w29ahmed/ECE298-Bicycle-Sensor/Prototype Design/F2019_ECE-298_Components/3d_Models/E298_led-3r_red.step

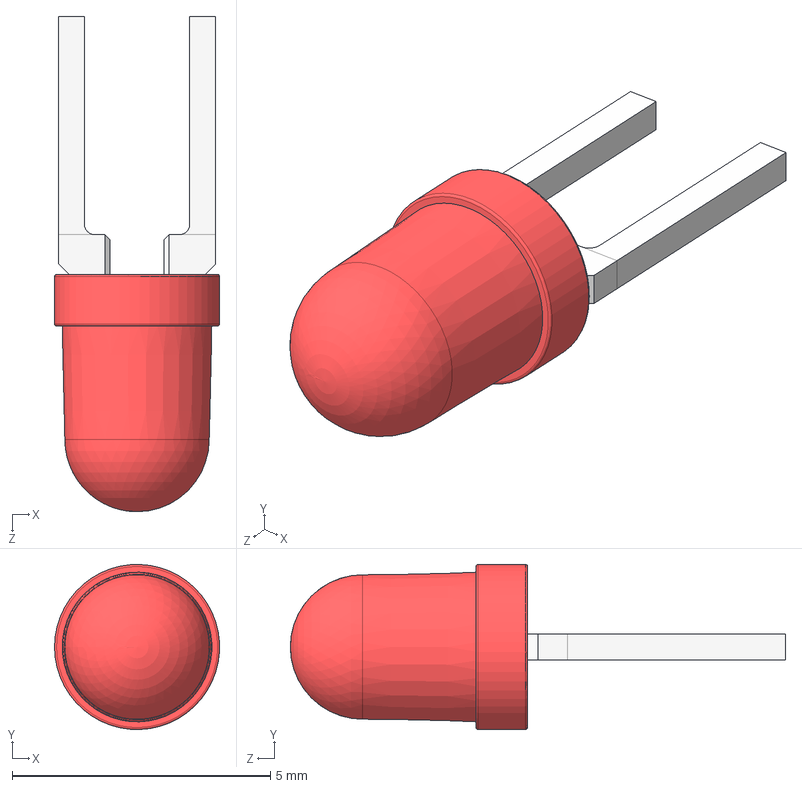
[picture p15: CAD file, 2019-10-06]
Prototype Design/F2019_ECE-298_Components/3d_Models/E298_led-3r_red.step
3.20 x 3.20 x 9.60 mm
