w29ahmed/ECE298-Bicycle-Sensor/Prototype Design/F2019_ECE-298_Components/3d_Models/E298_sot353.step

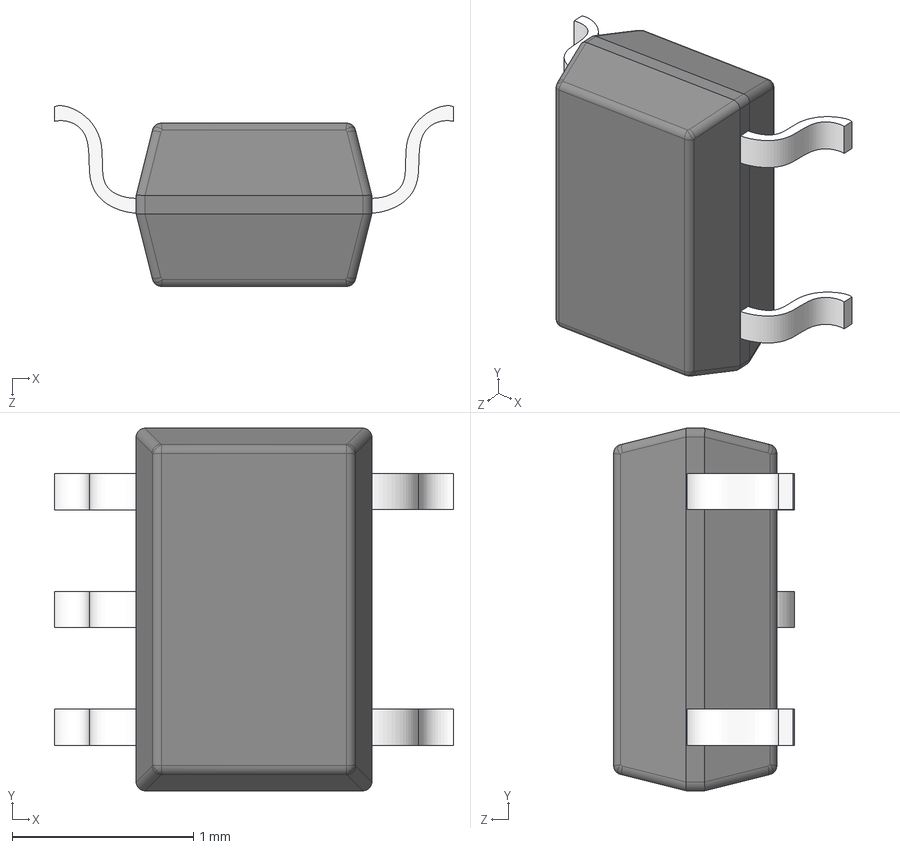
[picture p16: CAD file, 2019-10-06]
Prototype Design/F2019_ECE-298_Components/3d_Models/E298_sot353.step
2.20 x 2.00 x 0.996 mm
sot353
sot353_001
