w29ahmed/ECE298-Bicycle-Sensor/Prototype Design/F2019_ECE-298_Components/3d_Models/E298_hdr-1x5t_2.54_sh15x8.step

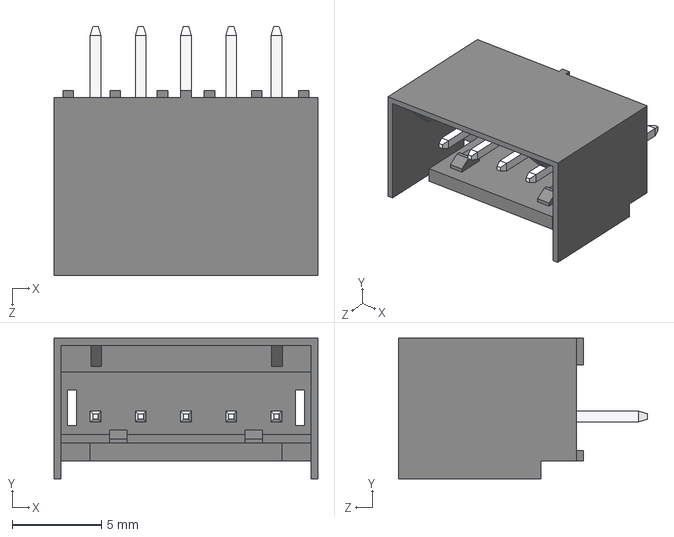
[picture p17: CAD file, 2019-10-06]
Prototype Design/F2019_ECE-298_Components/3d_Models/E298_hdr-1x5t_2.54_sh15x8.step
14.8 x 7.90 x 14.0 mm
