w29ahmed/ECE298-Bicycle-Sensor/Prototype Design/F2019_ECE-298_Components/3d_Models/E298_led-5r_green.step

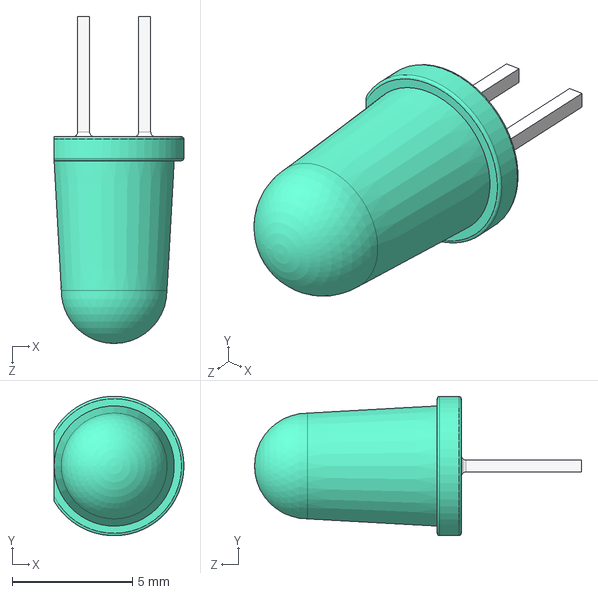
[picture p19: CAD file, 2019-10-06]
Prototype Design/F2019_ECE-298_Components/3d_Models/E298_led-5r_green.step
5.40 x 5.80 x 13.6 mm
