w29ahmed/ECE298-Bicycle-Sensor/Prototype Design/F2019_ECE-298_Components/3d_Models/E298_sot23-5.step

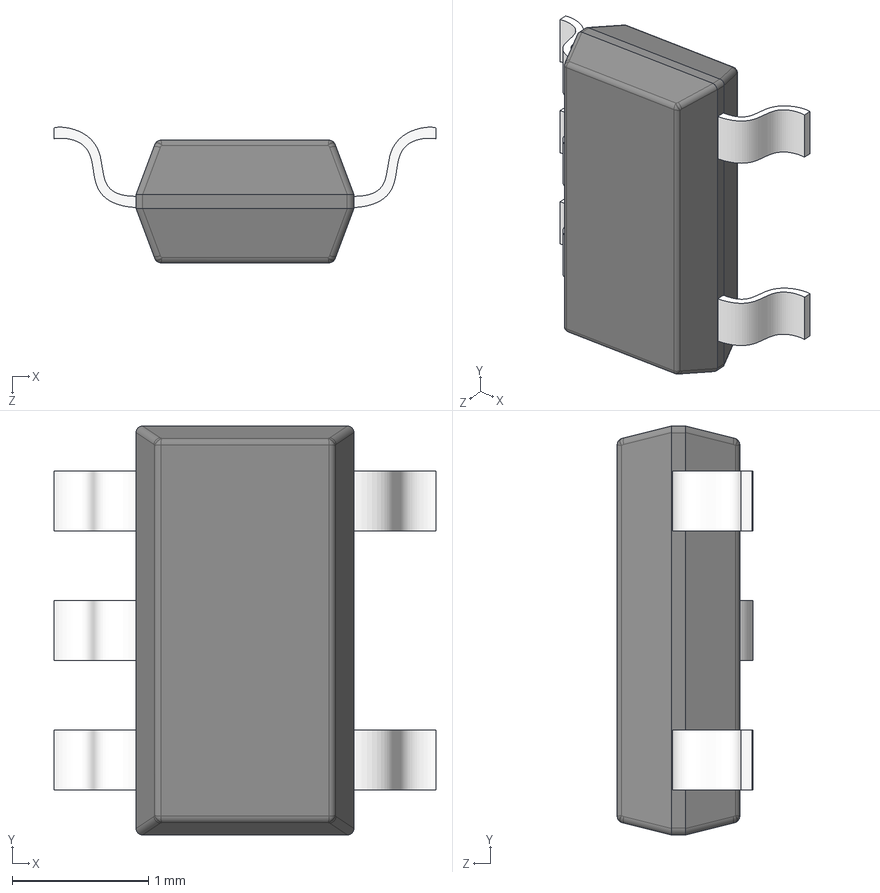
[picture p20: CAD file, 2019-10-06]
Prototype Design/F2019_ECE-298_Components/3d_Models/E298_sot23-5.step
2.80 x 3.00 x 0.995 mm
sot23-5
sot23-5_001
