w29ahmed/ECE298-Bicycle-Sensor/Prototype Design/F2019_ECE-298_Components/3d_Models/E298_TC-33X-2.step

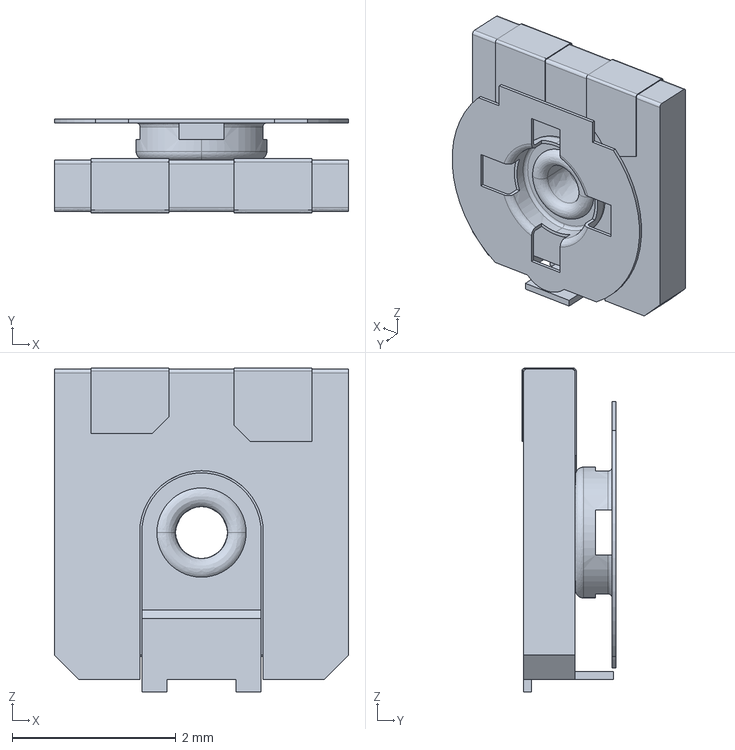
[picture p21: CAD file, 2019-10-06]
Prototype Design/F2019_ECE-298_Components/3d_Models/E298_TC-33X-2.step
3.60 x 1.15 x 3.96 mm
