w29ahmed/ECE298-Bicycle-Sensor/Prototype Design/F2019_ECE-298_Components/3d_Models/E298_EM-9745P-1.step

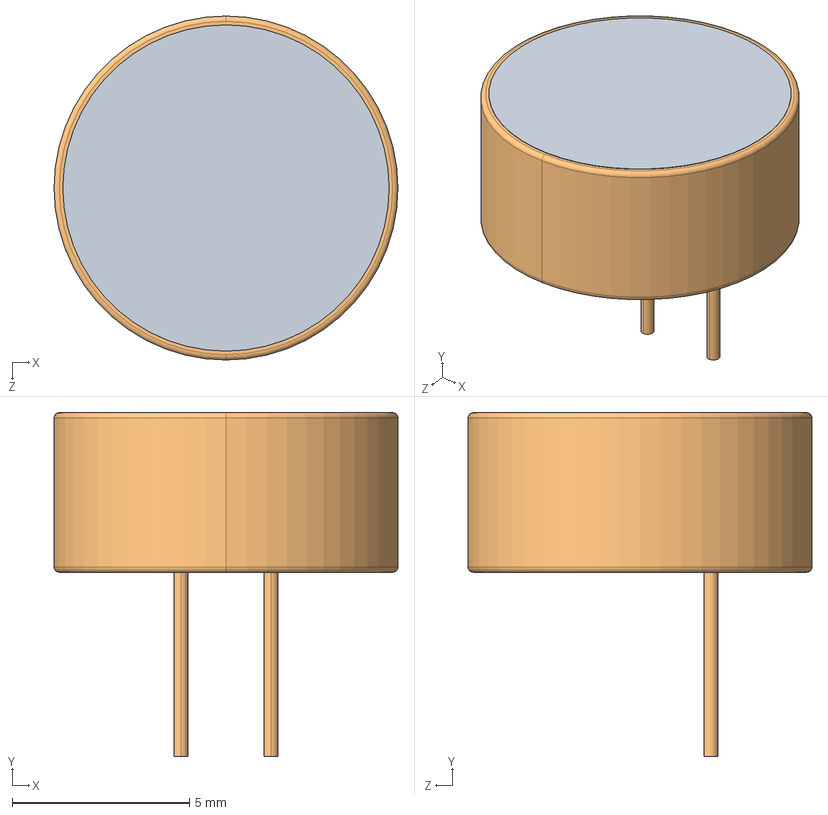
[picture p23: CAD file, 2019-10-06]
Prototype Design/F2019_ECE-298_Components/3d_Models/E298_EM-9745P-1.step
9.70 x 9.71 x 9.70 mm
