w29ahmed/ECE298-Bicycle-Sensor/Prototype Design/F2019_ECE-298_Components/3d_Models/E298_to-92.step

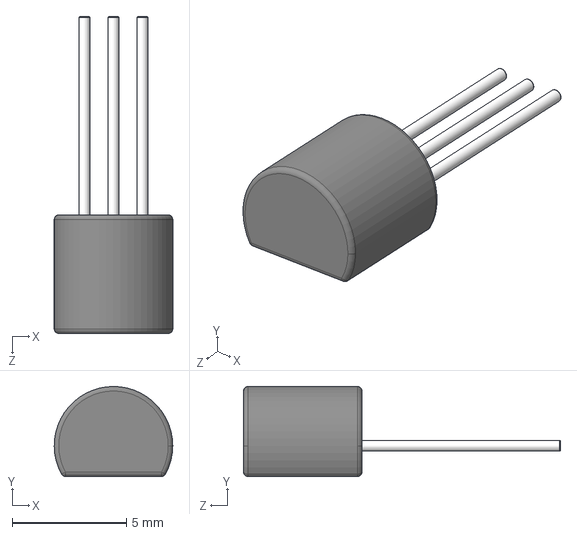
[picture p24: CAD file, 2019-10-06]
Prototype Design/F2019_ECE-298_Components/3d_Models/E298_to-92.step
5.20 x 3.95 x 13.9 mm
