w29ahmed/ECE298-Bicycle-Sensor/Prototype Design/F2019_ECE-298_Components/3d_Models/E298_soic-16_150mil.step

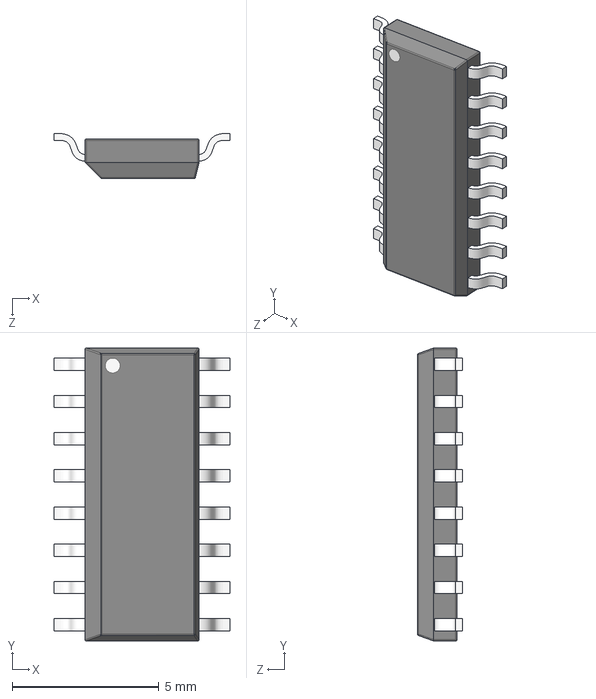
[picture p26: CAD file, 2019-10-06]
Prototype Design/F2019_ECE-298_Components/3d_Models/E298_soic-16_150mil.step
6.00 x 10.0 x 1.55 mm
soic-16_150mil
soic-16_150mil_001
