w29ahmed/ECE298-Bicycle-Sensor/Prototype Design/F2019_ECE-298_Components/3d_Models/E298_aom-6545p.step

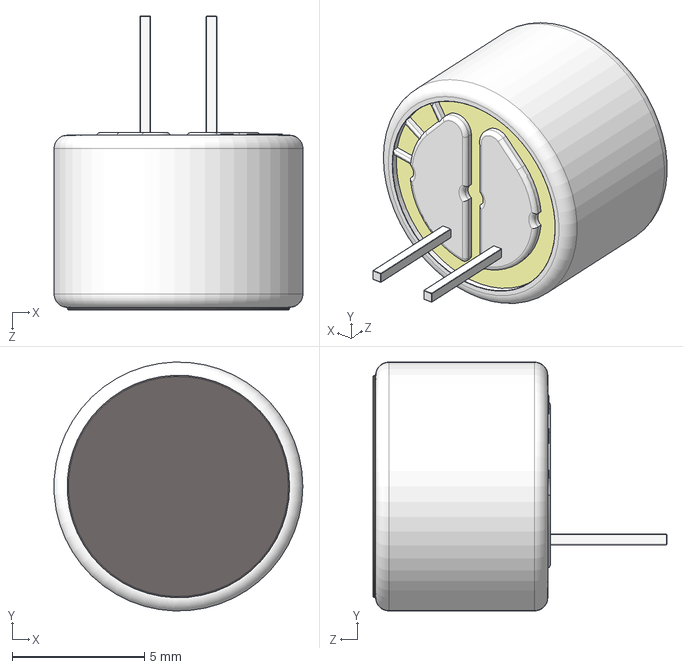
[picture p27: CAD file, 2019-10-06]
Prototype Design/F2019_ECE-298_Components/3d_Models/E298_aom-6545p.step
9.39 x 9.40 x 11.1 mm
