w29ahmed/ECE298-Bicycle-Sensor/Prototype Design/F2019_ECE-298_Components/3d_Models/E298_res_0805.step

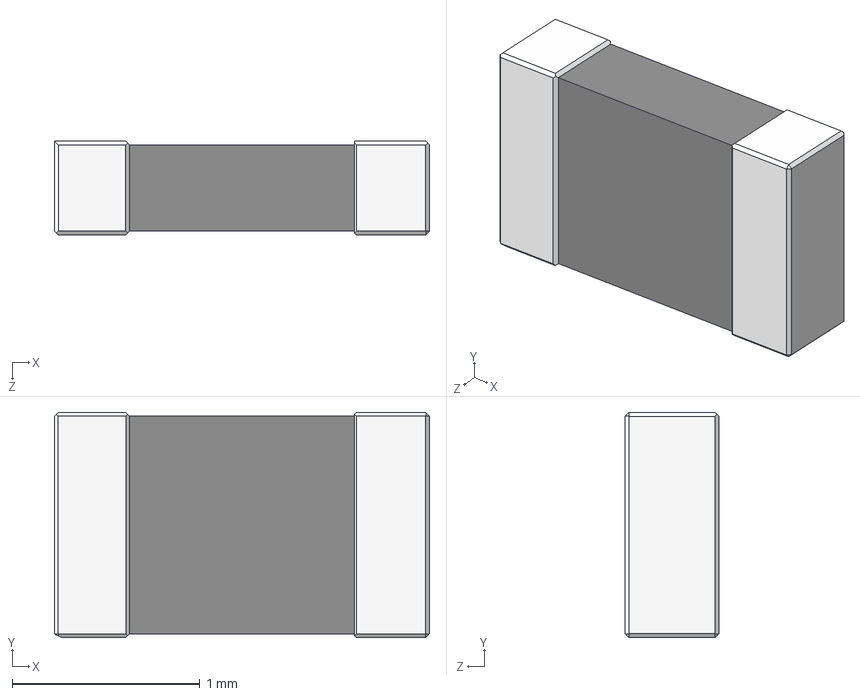
[picture p28: CAD file, 2019-10-06]
Prototype Design/F2019_ECE-298_Components/3d_Models/E298_res_0805.step
2.00 x 1.20 x 0.5 mm
