w29ahmed/ECE298-Bicycle-Sensor/Prototype Design/F2019_ECE-298_Components/3d_Models/E298_soic-8_150mil.step

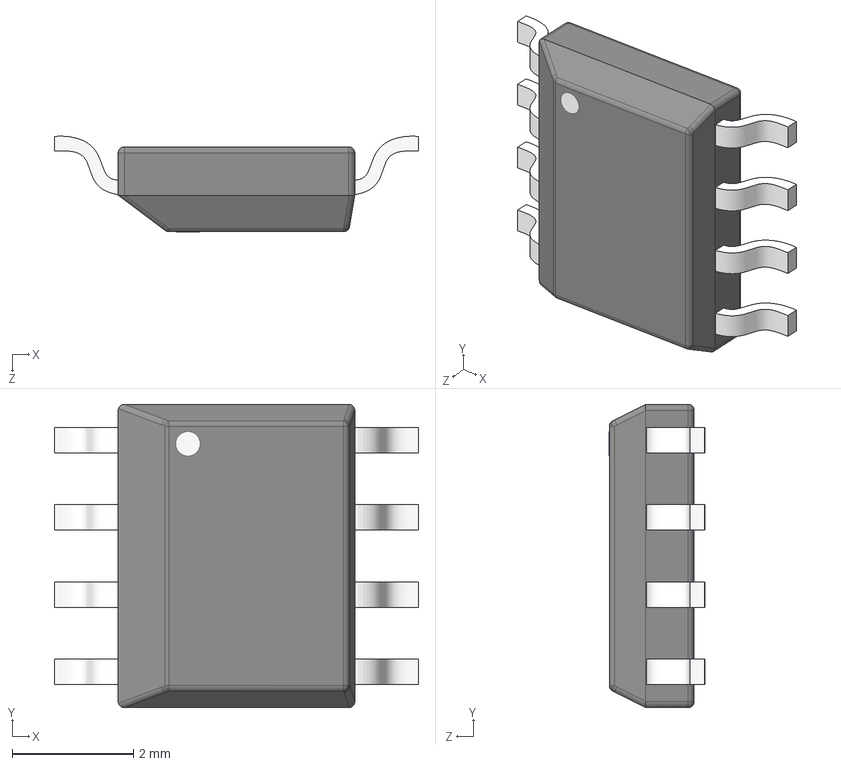
[picture p29: CAD file, 2019-10-06]
Prototype Design/F2019_ECE-298_Components/3d_Models/E298_soic-8_150mil.step
6.00 x 5.00 x 1.58 mm
soic-8_150mil
soic-8_150mil_001
