w29ahmed/ECE298-Bicycle-Sensor/Prototype Design/F2019_ECE-298_Components/3d_Models/E298_ssop-24_7.6x0.65.step

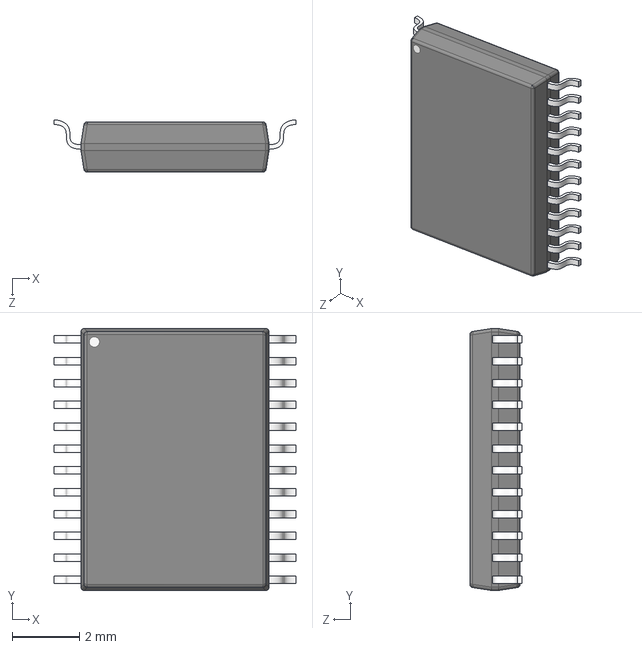
[picture p30: CAD file, 2019-10-06]
Prototype Design/F2019_ECE-298_Components/3d_Models/E298_ssop-24_7.6x0.65.step
7.20 x 7.80 x 1.56 mm
sop-24_7.6x0.65
sop-24_7.6x0.65_001
