w29ahmed/ECE298-Bicycle-Sensor/Prototype Design/F2019_ECE-298_Components/3d_Models/E298_hdrf-1x10t_2.54_26x3.step

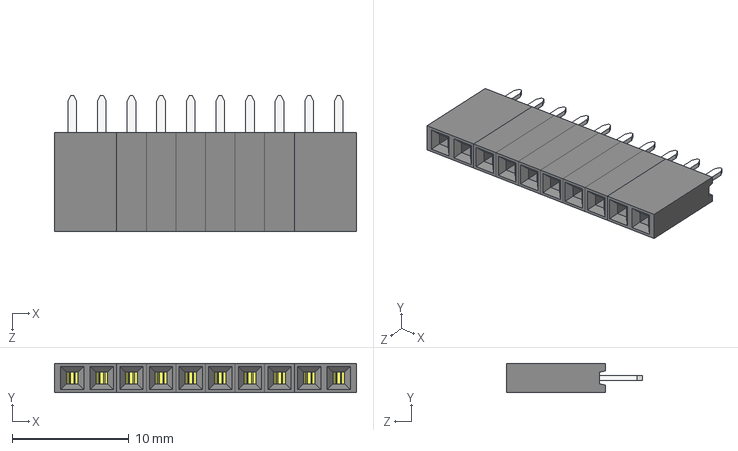
[picture p31: CAD file, 2019-10-06]
Prototype Design/F2019_ECE-298_Components/3d_Models/E298_hdrf-1x10t_2.54_26x3.step
25.9 x 2.50 x 11.7 mm
