w29ahmed/ECE298-Bicycle-Sensor/Prototype Design/F2019_ECE-298_Components/3d_Models/E298_pj-007.step

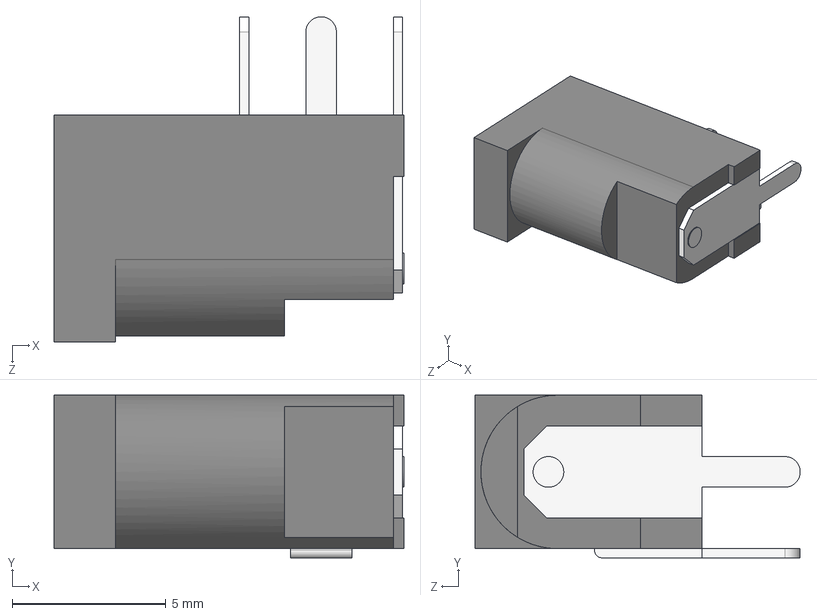
[picture p32: CAD file, 2019-10-06]
Prototype Design/F2019_ECE-298_Components/3d_Models/E298_pj-007.step
11.4 x 5.30 x 10.6 mm
