w29ahmed/ECE298-Bicycle-Sensor/Prototype Design/F2019_ECE-298_Components/3d_Models/E298_sod-523.step

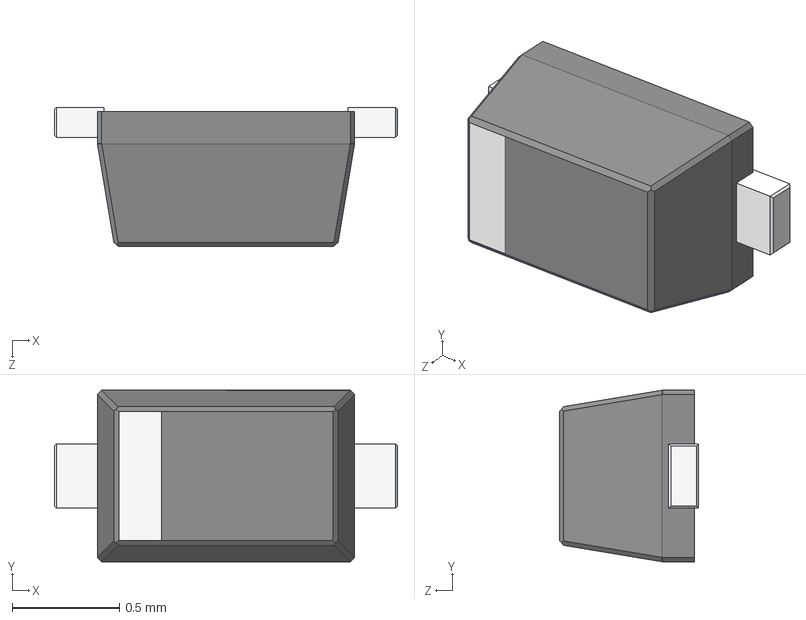
[picture p33: CAD file, 2019-10-06]
Prototype Design/F2019_ECE-298_Components/3d_Models/E298_sod-523.step
1.60 x 0.8 x 0.65 mm
