w29ahmed/ECE298-Bicycle-Sensor/Prototype Design/F2019_ECE-298_Components/3d_Models/E298_sop-4_4.85x1.27.step

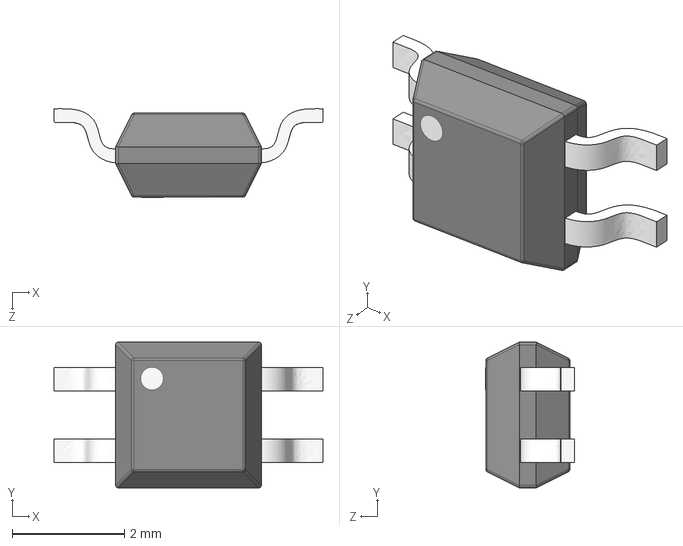
[picture p34: CAD file, 2019-10-06]
Prototype Design/F2019_ECE-298_Components/3d_Models/E298_sop-4_4.85x1.27.step
4.80 x 2.60 x 1.58 mm
sop-4_4.85x1.27
sop-4_4.85x1.27_001
