w29ahmed/ECE298-Bicycle-Sensor/Prototype Design/F2019_ECE-298_Components/3d_Models/E298_hs1100.step

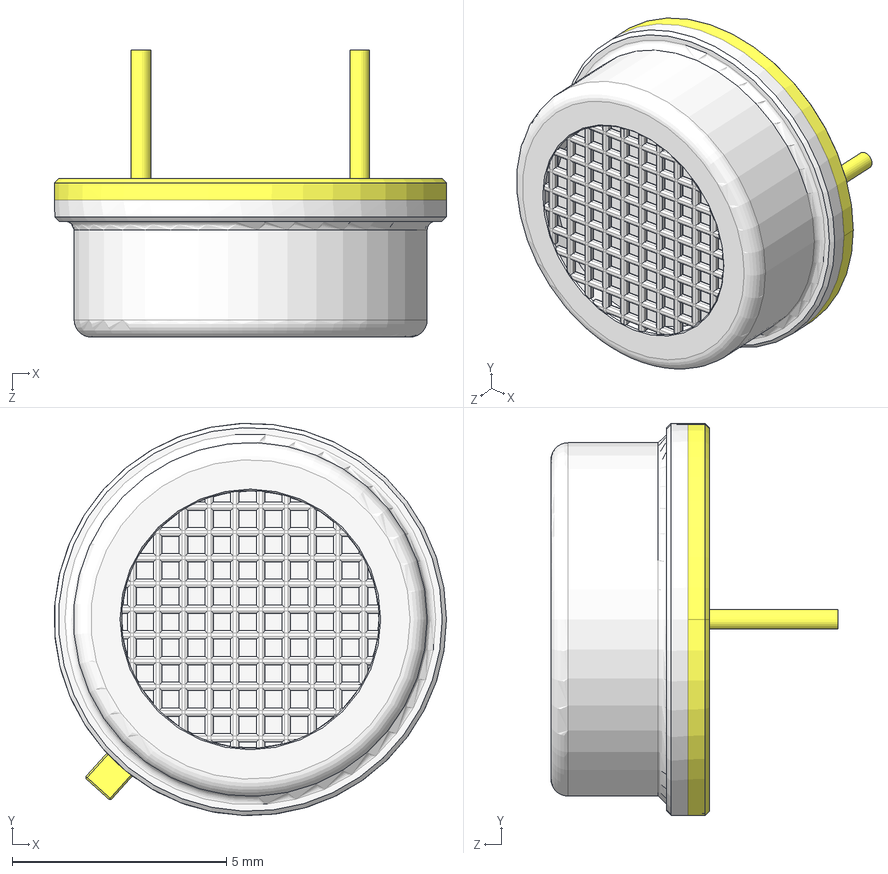
[picture p35: CAD file, 2019-10-06]
Prototype Design/F2019_ECE-298_Components/3d_Models/E298_hs1100.step
9.14 x 9.15 x 6.70 mm
