w29ahmed/ECE298-Bicycle-Sensor/Prototype Design/F2019_ECE-298_Components/3d_Models/E298_sot23.step

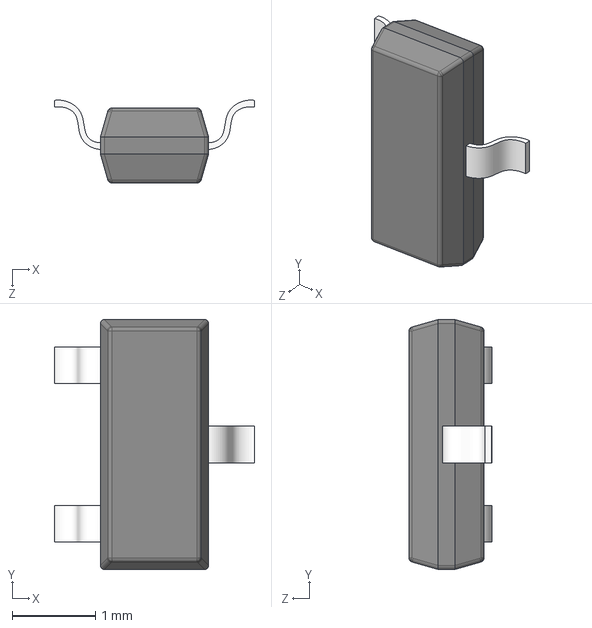
[picture p36: CAD file, 2019-10-06]
Prototype Design/F2019_ECE-298_Components/3d_Models/E298_sot23.step
2.40 x 3.00 x 0.996 mm
sot23
sot23_001
