w29ahmed/ECE298-Bicycle-Sensor/Prototype Design/F2019_ECE-298_Components/3d_Models/E298_EM-6022P.step

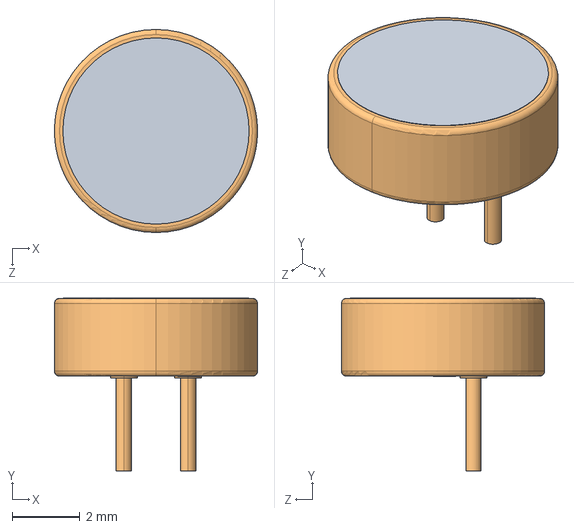
[picture p37: CAD file, 2019-10-06]
Prototype Design/F2019_ECE-298_Components/3d_Models/E298_EM-6022P.step
6.00 x 5.11 x 6.00 mm
