w29ahmed/ECE298-Bicycle-Sensor/Prototype Design/F2019_ECE-298_Components/3d_Models/E298_hdrf-1x4t_2.54_11x3.step

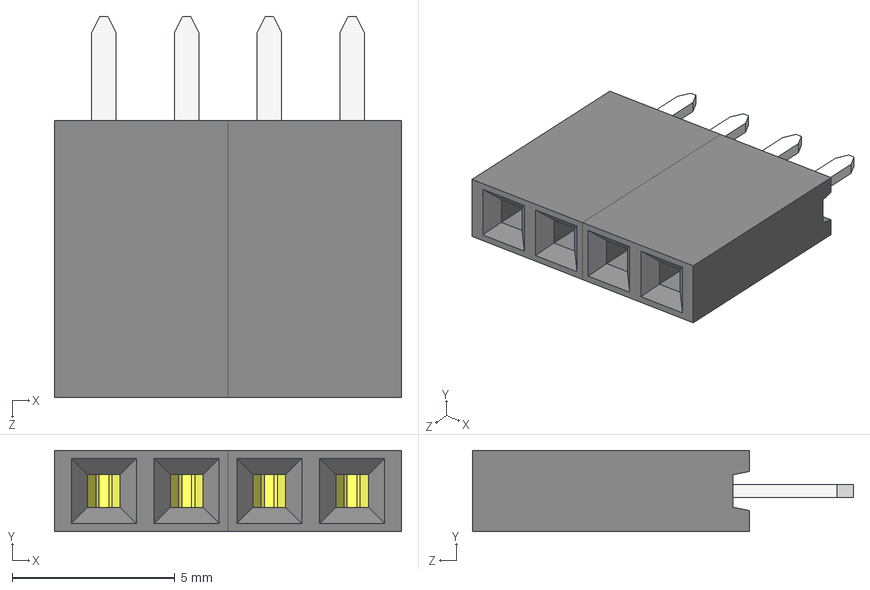
[picture p38: CAD file, 2019-10-06]
Prototype Design/F2019_ECE-298_Components/3d_Models/E298_hdrf-1x4t_2.54_11x3.step
10.7 x 2.50 x 11.7 mm
