w29ahmed/ECE298-Bicycle-Sensor/Prototype Design/F2019_ECE-298_Components/3d_Models/E298__capo-2.54_3.05x1.78.step

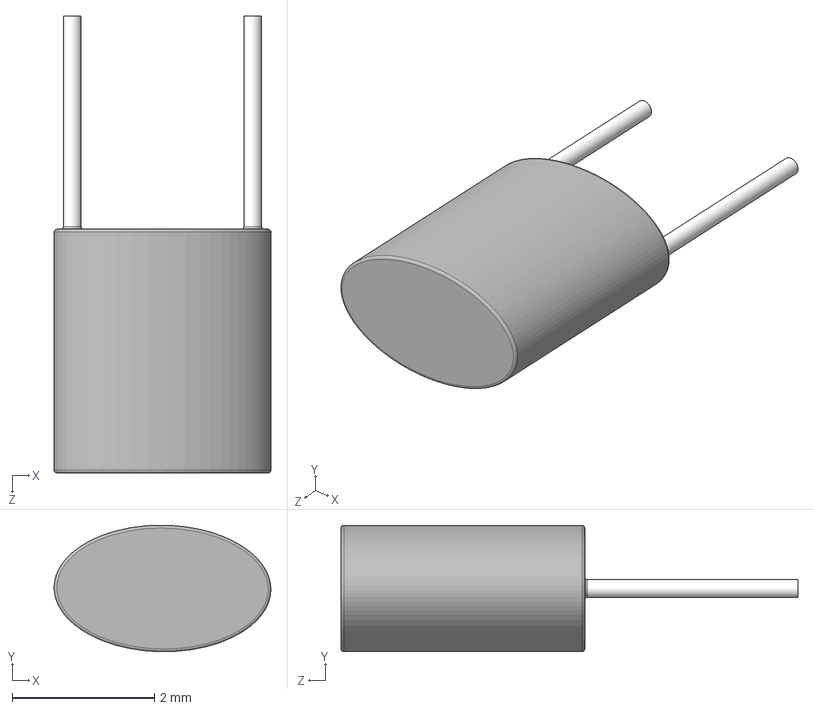
[picture p40: CAD file, 2019-10-06]
Prototype Design/F2019_ECE-298_Components/3d_Models/E298__capo-2.54_3.05x1.78.step
3.05 x 1.78 x 6.43 mm
