w29ahmed/ECE298-Bicycle-Sensor/Prototype Design/F2019_ECE-298_Components/3d_Models/E298_b3fs.step

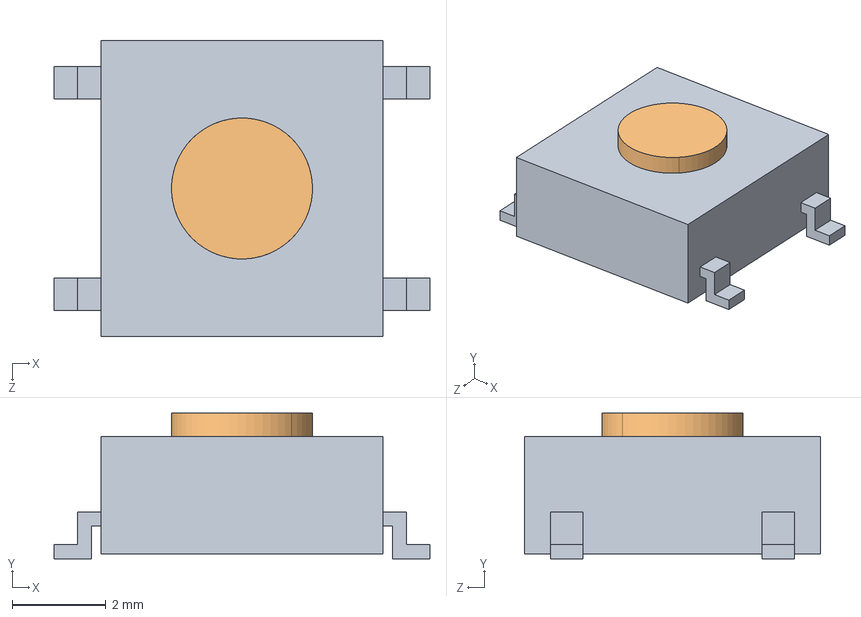
[picture p41: CAD file, 2019-10-06]
Prototype Design/F2019_ECE-298_Components/3d_Models/E298_b3fs.step
8.00 x 3.10 x 6.30 mm
B3FS_1000_BASE
B3FS_1000_BUTTON
