w29ahmed/ECE298-Bicycle-Sensor/Prototype Design/F2019_ECE-298_Components/3d_Models/E298_do-41.step

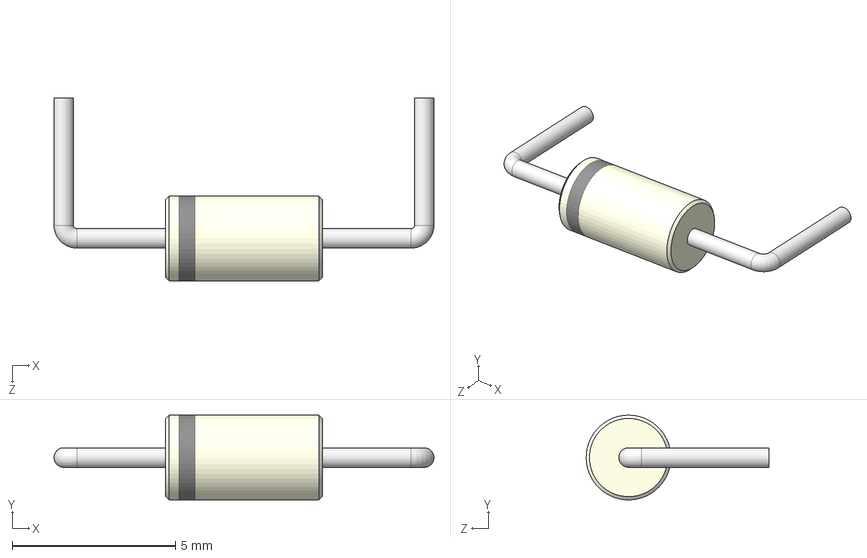
[picture p42: CAD file, 2019-10-06]
Prototype Design/F2019_ECE-298_Components/3d_Models/E298_do-41.step
11.6 x 2.60 x 5.60 mm
