w29ahmed/ECE298-Bicycle-Sensor/Prototype Design/F2019_ECE-298_Components/3d_Models/E298_hdrf-1x3t_2.54_8x3.step

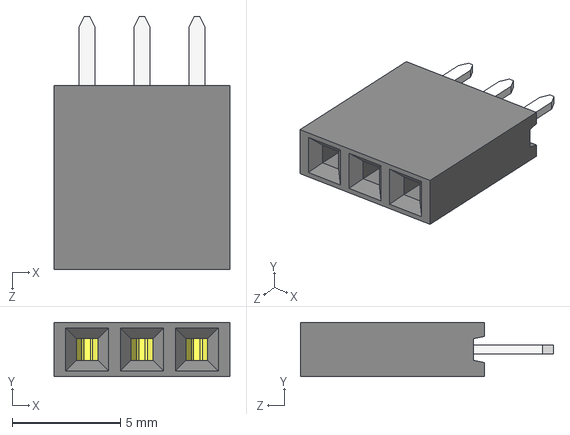
[picture p43: CAD file, 2019-10-06]
Prototype Design/F2019_ECE-298_Components/3d_Models/E298_hdrf-1x3t_2.54_8x3.step
8.12 x 2.50 x 11.7 mm
