w29ahmed/ECE298-Bicycle-Sensor/(list of files, cad)

Other CAD files:
Prototype Design/F2019_ECE-298_Components/3d_Models/E298_led-5r_yellow.step
Prototype Design/F2019_ECE-298_Components/3d_Models/E298_sot23-6.step
Prototype Design/F2019_ECE-298_Components/3d_Models/E298_led-5r_red.step
Prototype Design/F2019_ECE-298_Components/3d_Models/E298_led-3r_green.step
Prototype Design/F2019_ECE-298_Components/3d_Models/E298_led-3r_blue.step
Prototype Design/F2019_ECE-298_Components/3d_Models/E298_led-5r_blue.step
Prototype Design/F2019_ECE-298_Components/3d_Models/E298_led-3r_yellow.step
