w29ahmed/ECE298-Bicycle-Sensor/Feasibility Model Design/Feasibility Model Diagram.pdf

### Ultrasonic Sensor

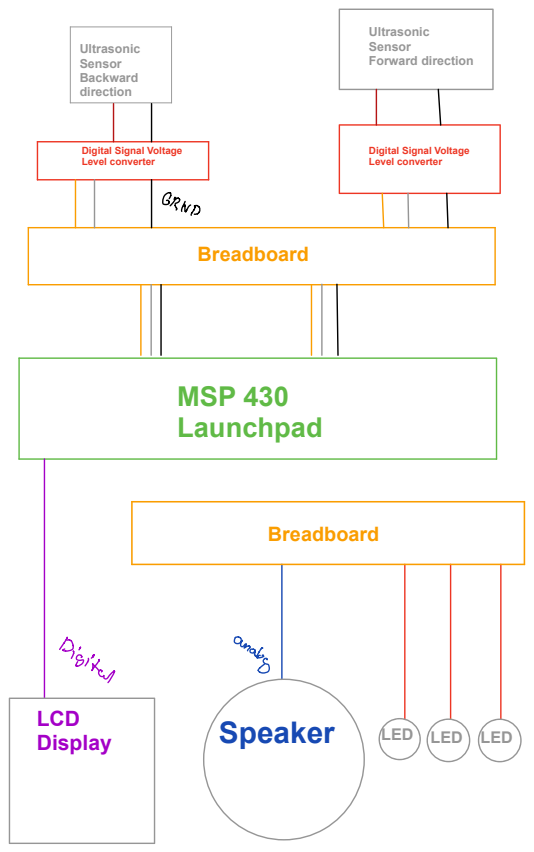
[picture p44: page 1]
GRND; big; analog; MSP 430 Launchpad; LCD; Display; Speaker; LED LED LED; Backward direction; Breadboard; Ultrasonic Sensor Forward direction

Digital Signal Voltage
Level converter

# Sensor

## Sensor

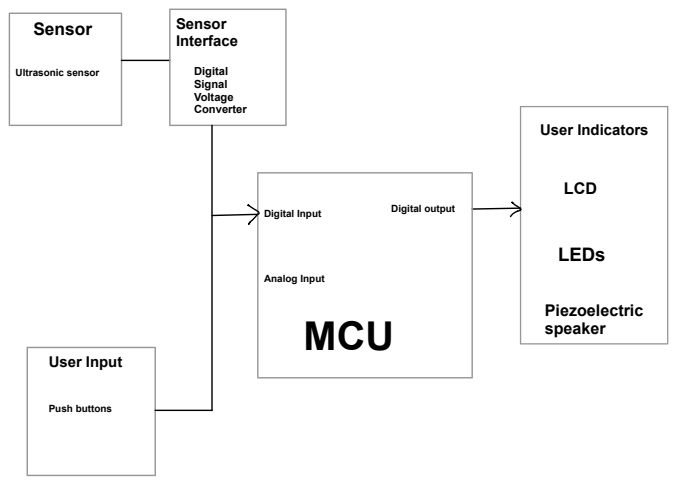
[picture p45: page 2]
Push buttons; MCU; Digital output; LCD; Piezoelectric speaker; LEDs; User Input; Ultrasonic sensor; Digital Input; Analog Input; Interface; Digital Signal Voltage Converter; User Indicators
