w29ahmed/ECE298-Bicycle-Sensor/Feasibility Model Design/Software Flowchart.pdf

# Initialize GPIO Pins

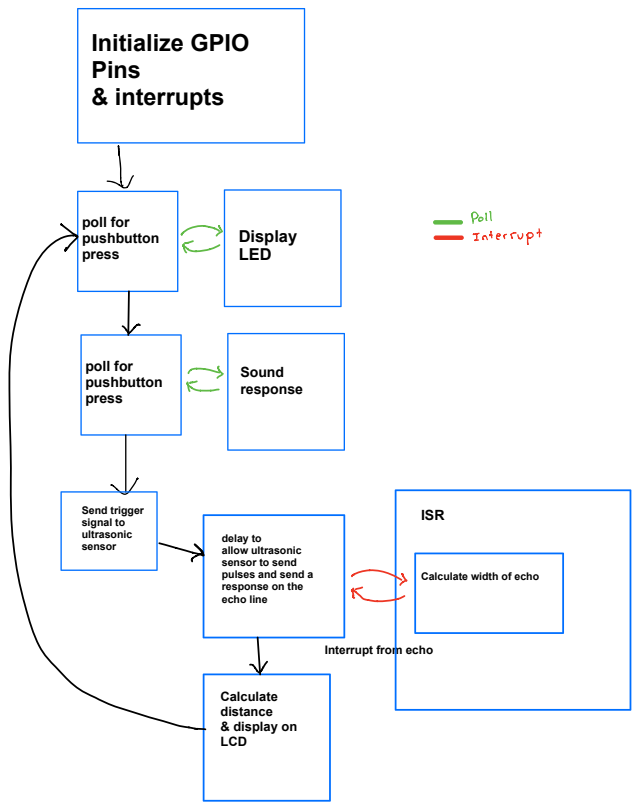
[picture p46: page 1]
Ii'terupt; & interrupts; poll for pushbutton press; Display LED; Sound response; Calculate distance & display on LCD; ISR; Send trigger signal to ultrasonic; sensor; delay to

allow ultrasonic
sensor to send
pulses and send a
response on the
echo line

Calculate width of echo

Interrupt from echo
