w29ahmed/ECE298-Bicycle-Sensor/(list of files, drawings)

Other design files:
Prototype Design/LS06_G2.dch
Prototype Design/LS06_G2.dip
