w29ahmed/ECE298-Bicycle-Sensor/src/Project1_ObjectDetector/buzzer.c

#include "buzzer.h"
#include <msp430fr4133.h>

// Original source code taken from: http://processors.wiki.ti.com/index.php/Playing_The_Imperial_March

void delay_ms(unsigned int ms )
{
    unsigned int i;
    for (i = 0; i<= ms; i++)
       __delay_cycles(500); //Built-in function that suspends the execution for 500 cicles
}

void delay_us(unsigned int us )
{
    unsigned int i;
    for (i = 0; i<= us/2; i++)
       __delay_cycles(1);
}

//This function generates the square wave that makes the piezo speaker sound at a determinated frequency.
void beep(unsigned int note, unsigned int duration)
{
    int i;
    long delay = (long)(10000/note);  //This is the semiperiod of each note.
    long time = (long)((duration*100)/(delay*2));  //This is how much time we need to spend on the note.
    for (i=0;i<time;i++)
    {
        P1OUT |= BIT7;     //Set P1.7...
        delay_us(delay);   //...for a semiperiod...
        P1OUT &= ~BIT7;    //...then reset it...
        delay_us(delay);   //...for the other semiperiod.
    }
    delay_ms(20); //Add a little delay to separate the single notes
}
