w29ahmed/ECE298-Bicycle-Sensor/(commit log)

2019-09-21 Project files
    [LS6_T2-1.xlsx]
2019-09-25 Feasibility model source code for demo (#1)
    - Interfaced ultrasonic sensor
    - Used push buttons, LED, and piezo electric buzzer
    [buzzer.c, hal_LCD.c, hal_LCD.h, main.c, main.h]
2019-09-25 Moved feasibility model stuff into it's own folder
    [LS6_T2-1.xlsx]
2019-10-06 added in schematic diagram
    [E298_EM-6022P.step, E298_EM-9745P-1.step, E298_TC-33X-2.step, E298__capo-2.54_3.05x1.78.step, E298_aom-6545p.step, E298_b3fs.step, E298_cap-2.54_3.18x3.18.step, E298_cap_0805.step]
2019-10-07 Added LEDs and setupmode (#2)
    - Added gpio for 4 leds (green, yellow, orange, red)
    - Allowed switching between user and setup mode through a PB interrupt
    - Added workflow for changing threshold values in setup mode (forward facing only atm)
2019-10-09 finished schematic BOM still need
    [SchematicBicycle.dch]
2019-10-09 Fixed up schematic
    [SchematicBicycle.dch]
2019-10-09 Fixed device capacitors and added BOM to schematic
    [SchematicBicycle.dch]
2019-10-09 new folder for Prototype Design
2019-10-09 Moved files
    [E298_EM-6022P.step, E298_EM-9745P-1.step, E298_TC-33X-2.step, E298__capo-2.54_3.05x1.78.step, E298_aom-6545p.step, E298_b3fs.step, E298_cap-2.54_3.18x3.18.step, E298_cap_0805.step]
2019-10-10 Changed wire for ultrasonic to a GPIO capable of interrupts
    [LS06_G2.dch, SchematicBicycle.dch]
2019-10-11 Filled in prototype design document
2019-10-11 Mistake on pin assingment for echo and trigger - fixed in schematic and report
    [LS06_G2.dch]
2019-10-30 created init pcb design
    [LS06_G2.dch, LS06_G2.dip]
2019-10-30 fixed schematic diagram
    [LS06_G2.dch, LS06_G2.dip]
2019-10-30 added in fixed init pcb
    [LS06_G2.dip]
2019-10-30 working on pcb
    [LS06_G2.dip]
2019-10-30 added all components except pb
    [LS06_G2.dch, pcbdesign.dip]
2019-10-30 majority of the wiring done
    [LS06_G2.dip, pcbdesign.dip]
2019-10-31 added everything but button
    [pcbdesign.dip]
2019-10-31 fixed power signals and capactior placement
    [LS06_G2.dch, LS06_G2.dip, pcbdesign.dip]
2019-10-31 fixed word placement
    [LS06_G2.dip]
2019-11-01 Matched up pin assignments to updates one in schematic
2019-11-01 fixed pcb text error
    [LS06_G2.dip]
2019-11-03 - copper pour
    [LS06_G2.dip]
2019-11-15 added parts list for pcb
    [GeneratedPartsListPCB.xlsx, Project_Parts_Ordering (1).xlsm, Project_Parts_Ordering.xlsm]
2019-11-18 Added support for forward proximity sensor
2019-11-18 Added setup mode for forward sensor
2019-11-19 parts list 4
    [LS6_T1-4.xlsx]
2019-11-21 moved parts list into parts list folder
    [GeneratedPartsListPCB.xlsx, LS6_T1-4.xlsx, Project_Parts_Ordering (1).xlsm, Project_Parts_Ordering.xlsm]
2019-11-21 Don't need to init adc, pwn, or uart
2019-11-21 Threshold edge case
2019-11-25 Changed order of 2 slides for better flow
2019-12-02 Added updated software flowchart
2019-12-03 Got rid of all instructions in brackets
2019-12-30 Got rid of parts list
    [GeneratedPartsListPCB.xlsx, LS6_T1-4.xlsx, LS6_T2-1.xlsx, Project_Parts_Ordering.xlsm]
